glennji/field-outpost-zero/branding/foz-contact-sheet.png

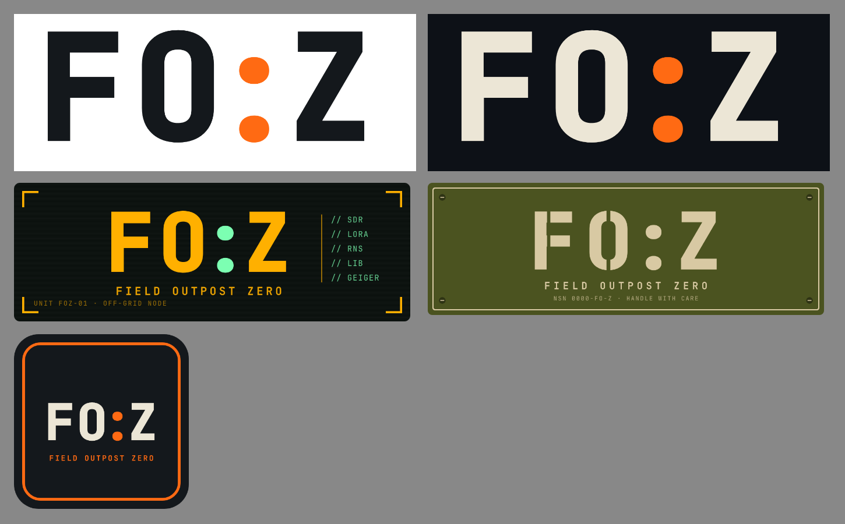
branding/foz-contact-sheet.png
