glennji/field-outpost-zero/branding/foz-wordmark-light.png

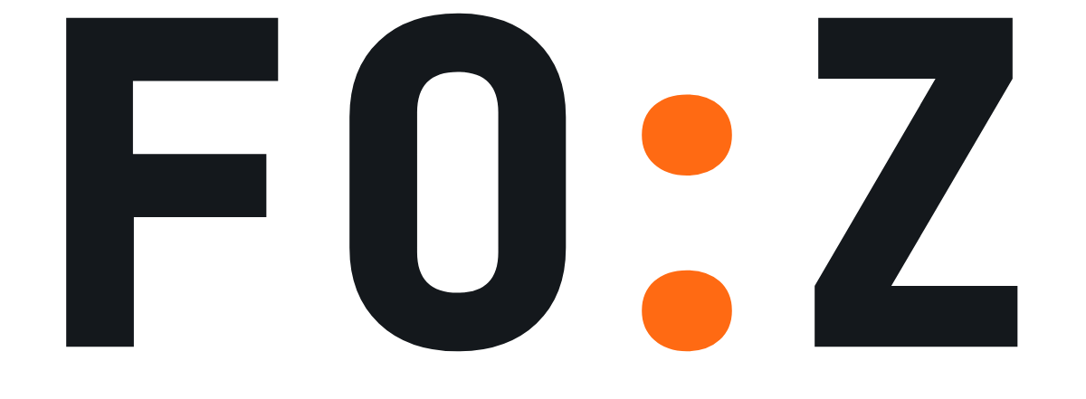
branding/foz-wordmark-light.png
