glennji/field-outpost-zero/preview/base_tile_5x5.png

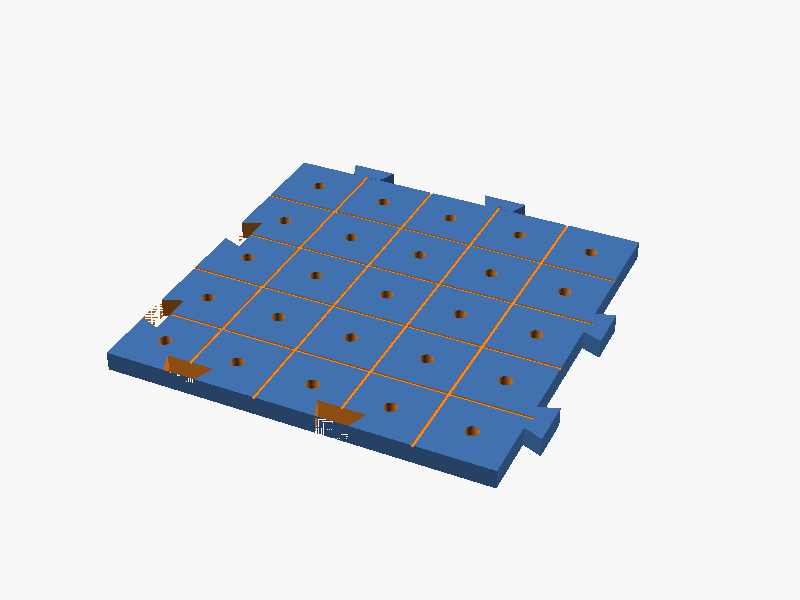
preview/base_tile_5x5.png
