glennji/field-outpost-zero/preview/board_tray_orangepi.png

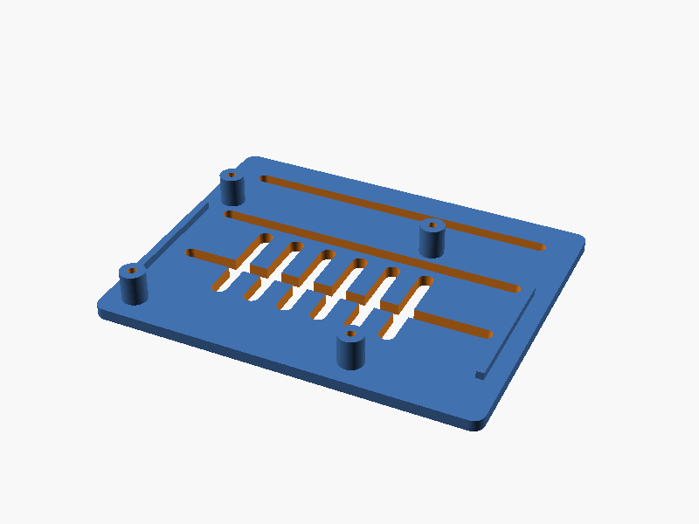
preview/board_tray_orangepi.png
