glennji/field-outpost-zero/preview/contact_sheet.png

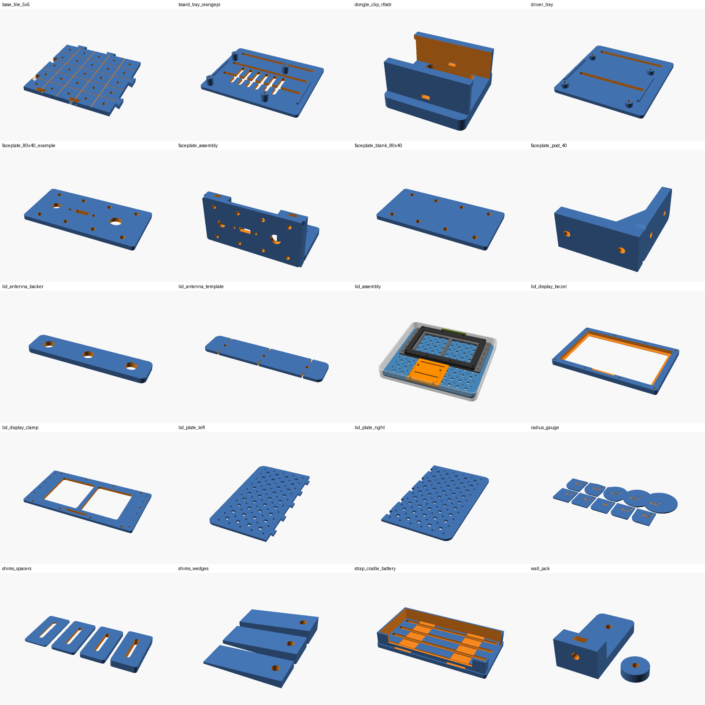
preview/contact_sheet.png
