glennji/field-outpost-zero/preview/dongle_clip_rtlsdr.png

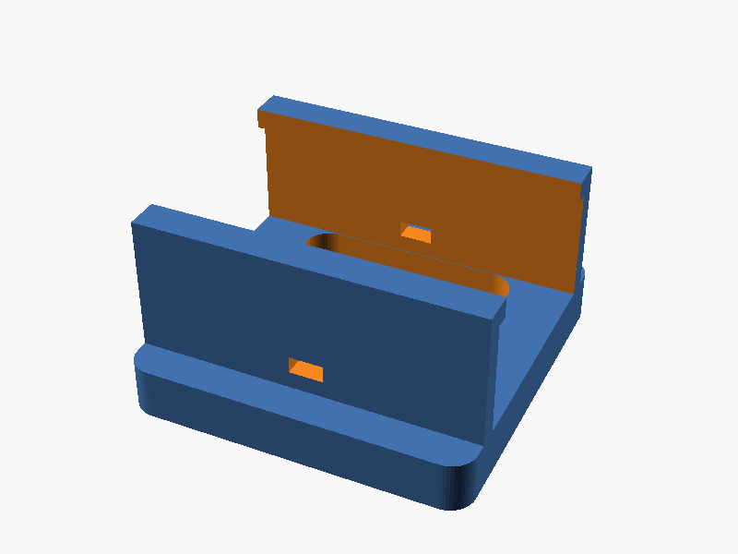
preview/dongle_clip_rtlsdr.png
