glennji/field-outpost-zero/preview/driver_tray.png

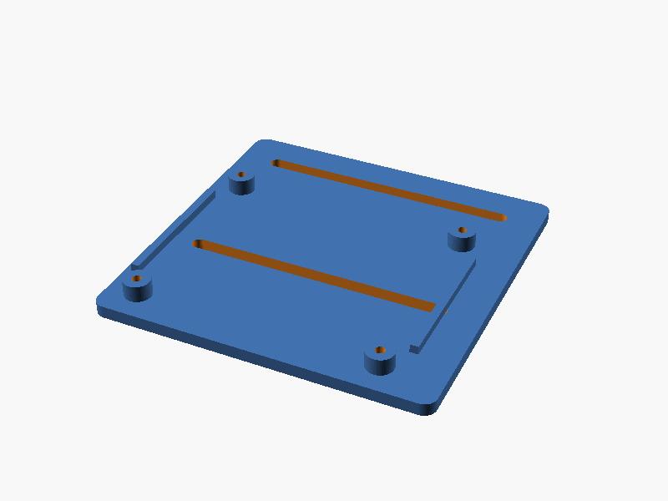
preview/driver_tray.png
