glennji/field-outpost-zero/preview/faceplate_80x40_example.png

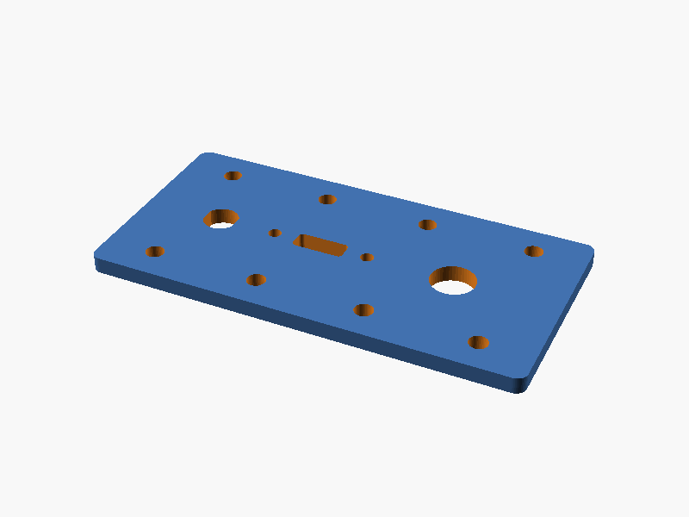
preview/faceplate_80x40_example.png
