glennji/field-outpost-zero/preview/faceplate_post_40.png

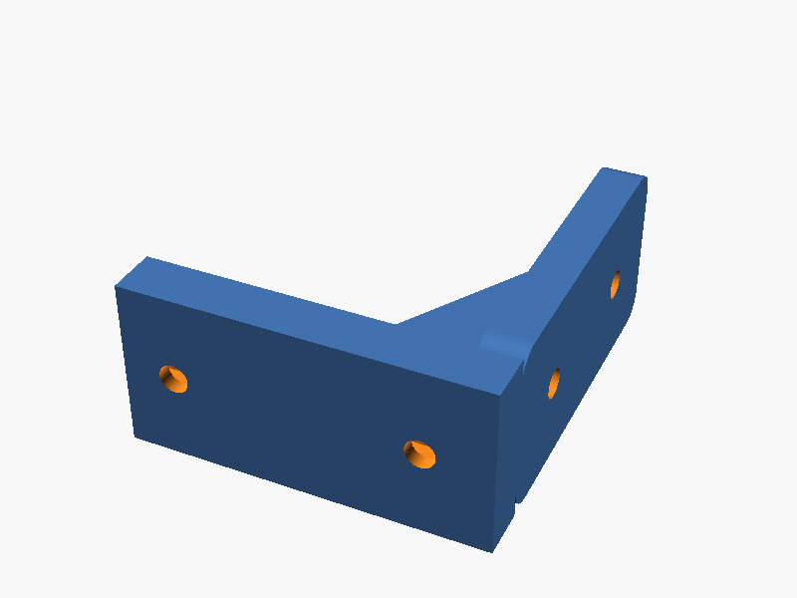
preview/faceplate_post_40.png
