glennji/field-outpost-zero/preview/lid_antenna_backer.png

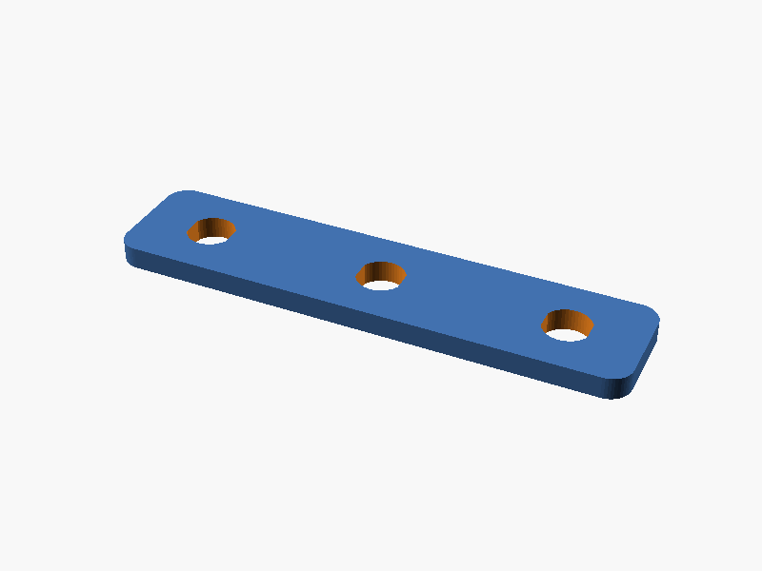
preview/lid_antenna_backer.png
