glennji/field-outpost-zero/preview/lid_display_bezel.png

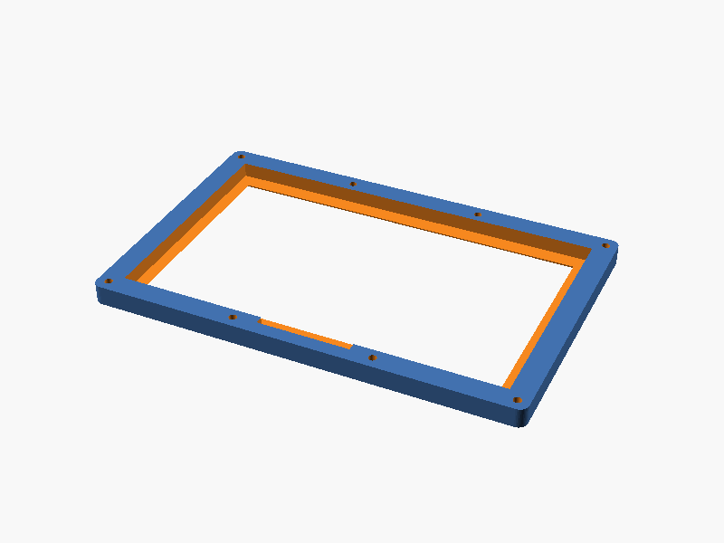
preview/lid_display_bezel.png
