glennji/field-outpost-zero/preview/lid_display_clamp.png

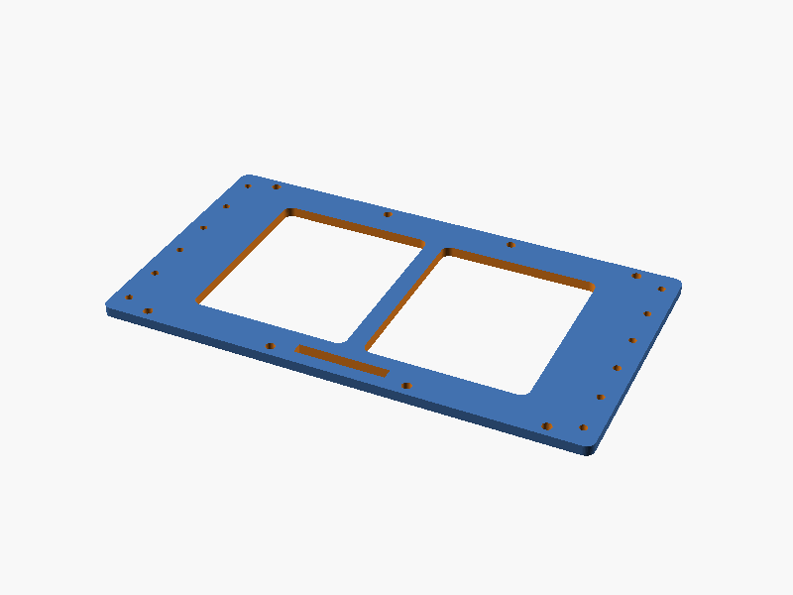
preview/lid_display_clamp.png
