glennji/field-outpost-zero/preview/lid_plate_left.png

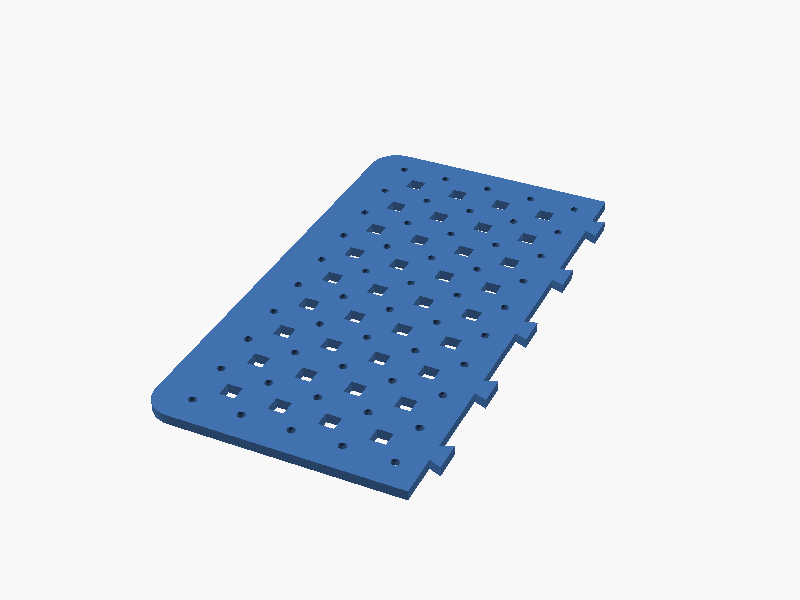
preview/lid_plate_left.png
