glennji/field-outpost-zero/preview/radius_gauge.png

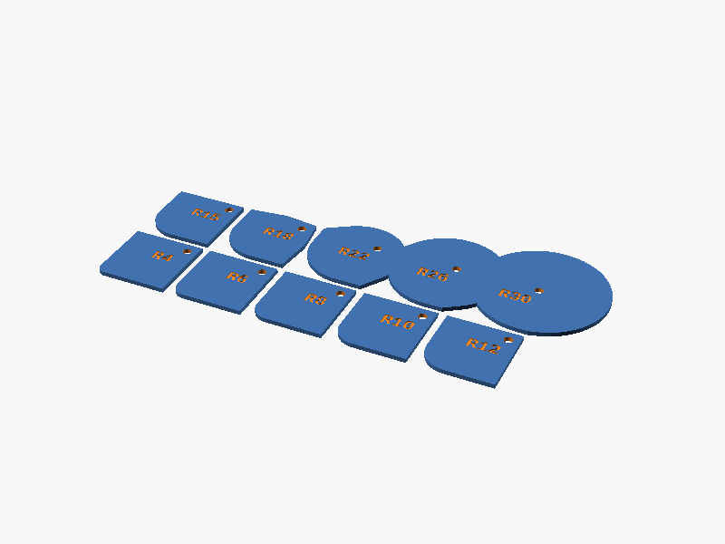
preview/radius_gauge.png
