glennji/field-outpost-zero/preview/shims_wedges.png

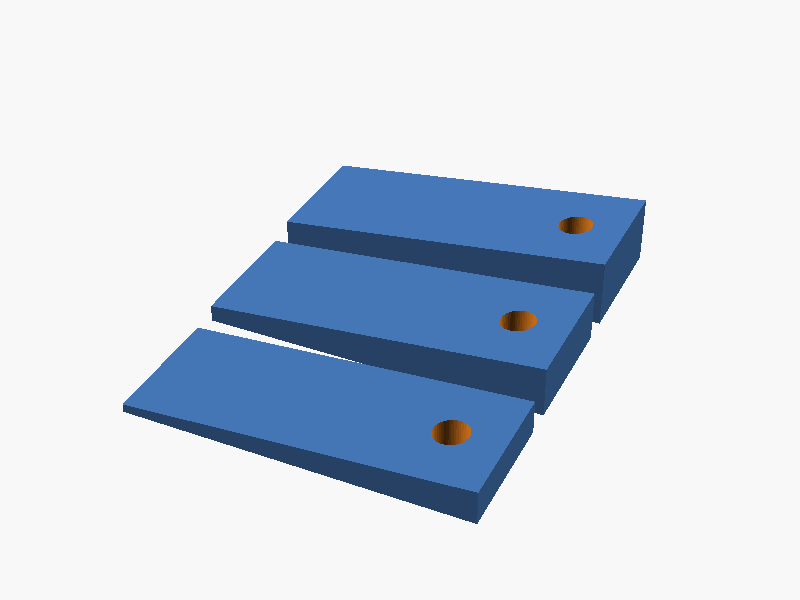
preview/shims_wedges.png
