glennji/field-outpost-zero/preview/wall_jack.png

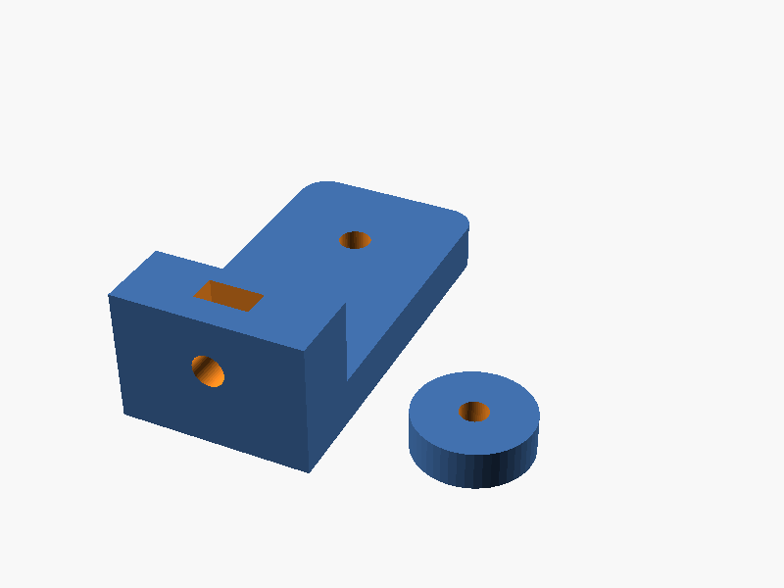
preview/wall_jack.png
