glennji/field-outpost-zero/stl/lid_plate_full.stl

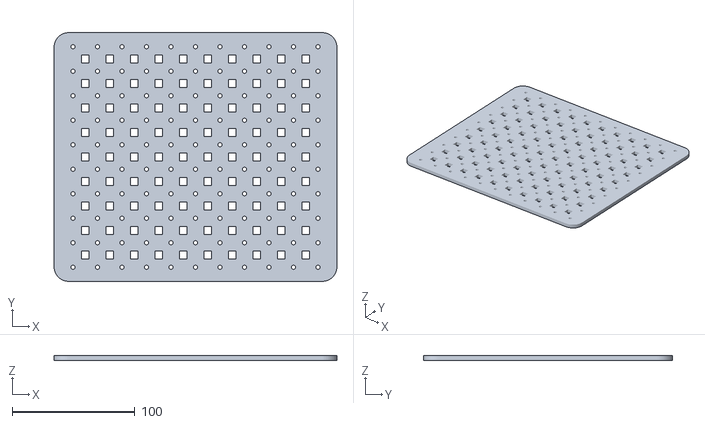
[picture p18: CAD file, 2026-10-24]
stl/lid_plate_full.stl
231.0 x 203.0 x 4.00
