glennji/field-outpost-zero/stl/lid_antenna_template.stl

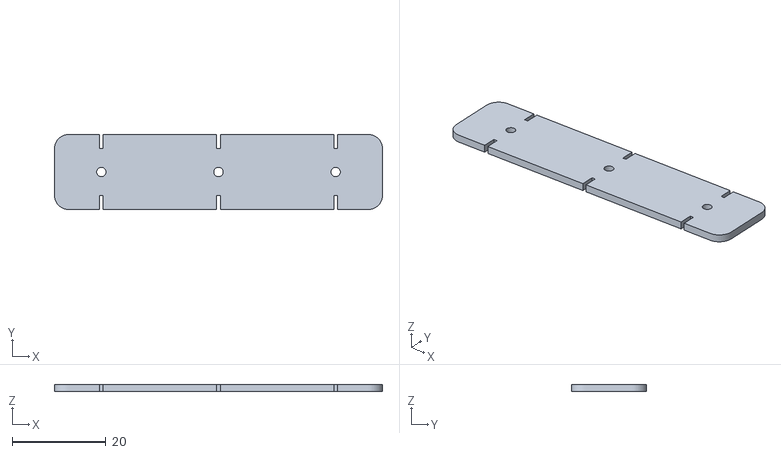
[picture p19: CAD file, 2026-10-24]
stl/lid_antenna_template.stl
70.0 x 16.0 x 1.60
