glennji/field-outpost-zero/stl/lid_plate_left.stl

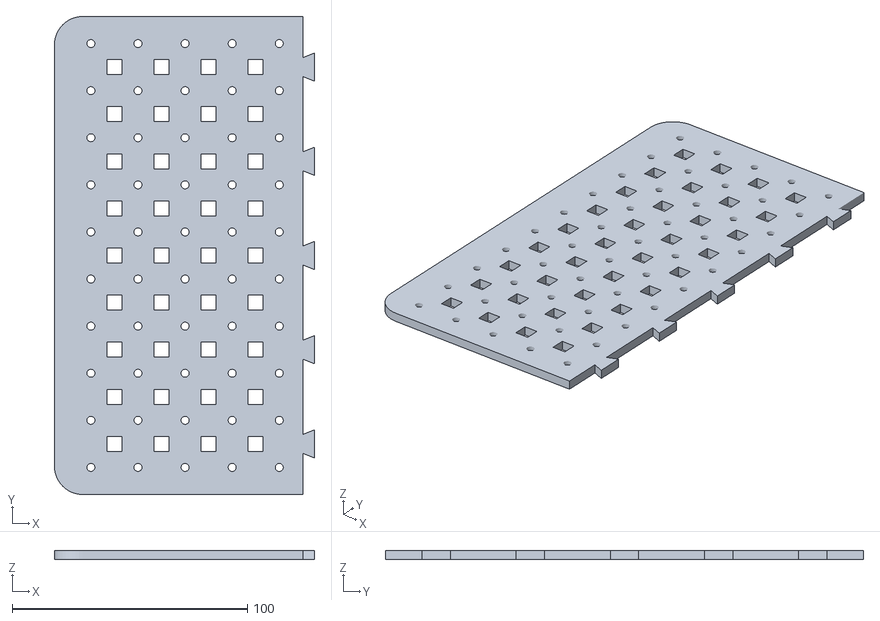
[picture p20: CAD file, 2026-10-24]
stl/lid_plate_left.stl
110.5 x 203.0 x 4.00
