glennji/field-outpost-zero/stl/wall_jack.stl

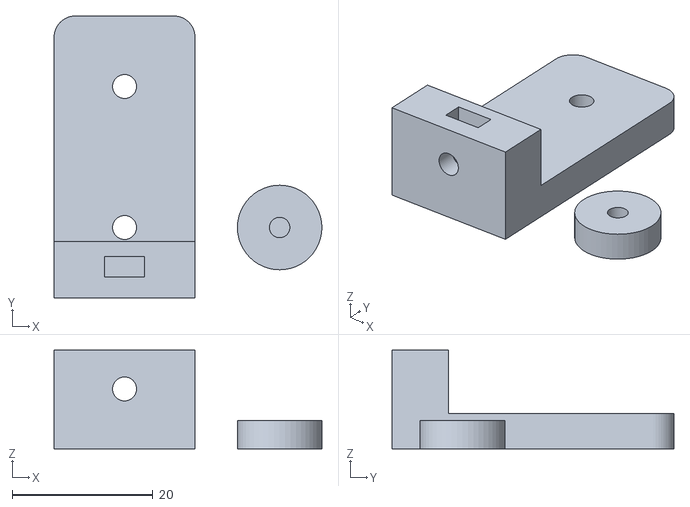
[picture p21: CAD file, 2026-10-24]
stl/wall_jack.stl
38.0 x 40.0 x 14.0
