glennji/field-outpost-zero/stl/lid_antenna_backer.stl

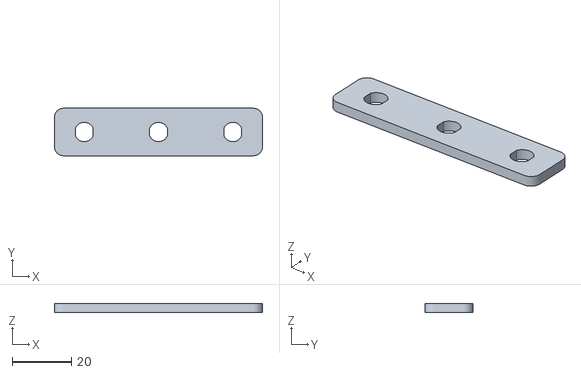
[picture p22: CAD file, 2026-10-24]
stl/lid_antenna_backer.stl
70.0 x 16.0 x 3.00
