glennji/field-outpost-zero/stl/driver_tray.stl

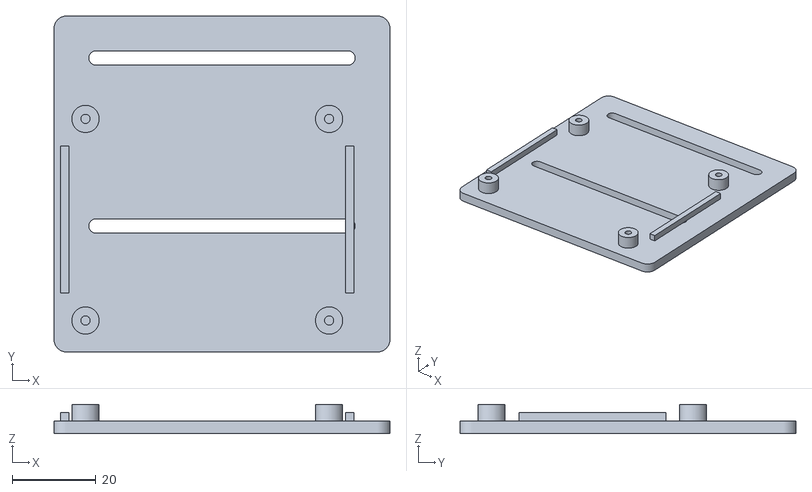
[picture p23: CAD file, 2026-10-24]
stl/driver_tray.stl
80.0 x 80.0 x 7.00
