glennji/field-outpost-zero/stl/dongle_clip_rtlsdr.stl

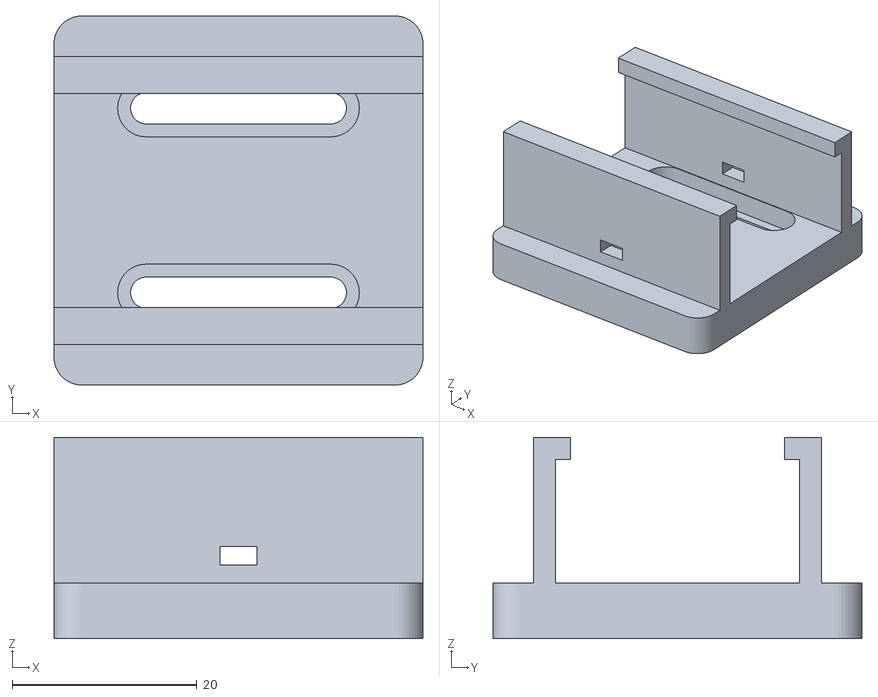
[picture p24: CAD file, 2026-10-24]
stl/dongle_clip_rtlsdr.stl
40.0 x 40.0 x 21.8
