glennji/field-outpost-zero/stl/faceplate_post_40.stl

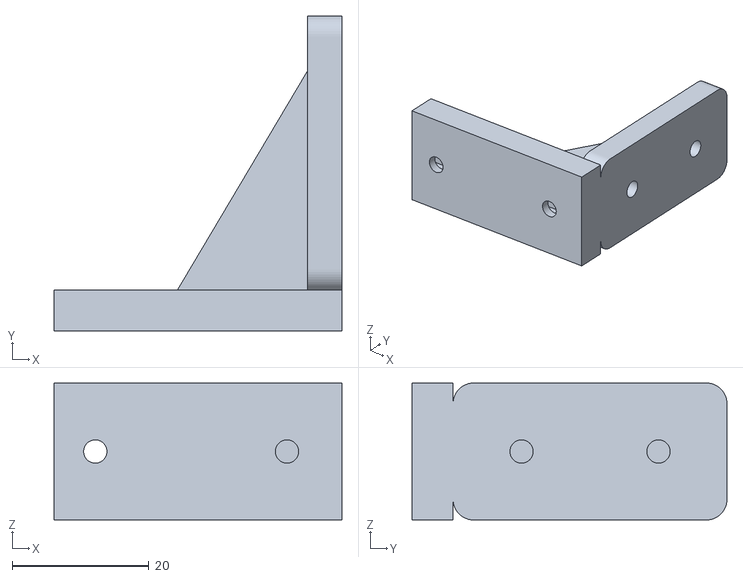
[picture p25: CAD file, 2026-10-24]
stl/faceplate_post_40.stl
42.0 x 46.0 x 20.0
