glennji/field-outpost-zero/stl/lid_plate_right.stl

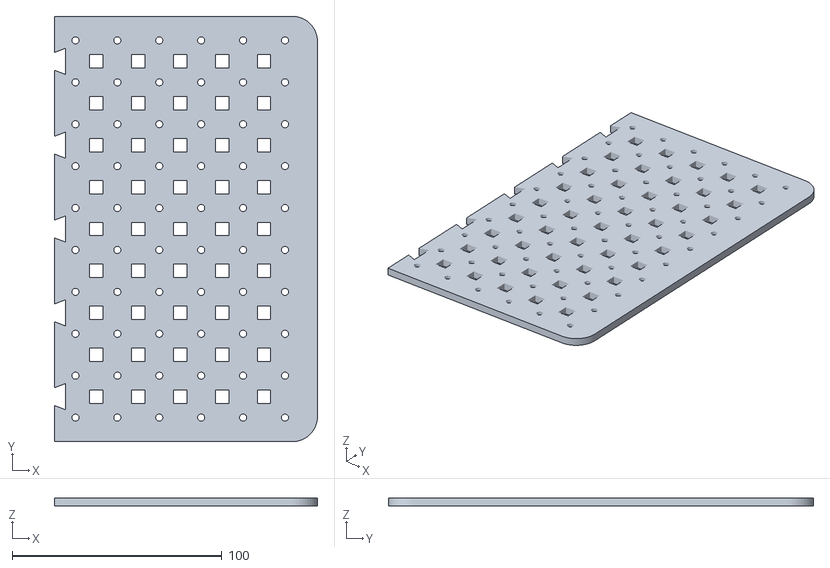
[picture p26: CAD file, 2026-10-24]
stl/lid_plate_right.stl
125.5 x 203.0 x 4.00
