glennji/field-outpost-zero/stl/faceplate_80x40_example.stl

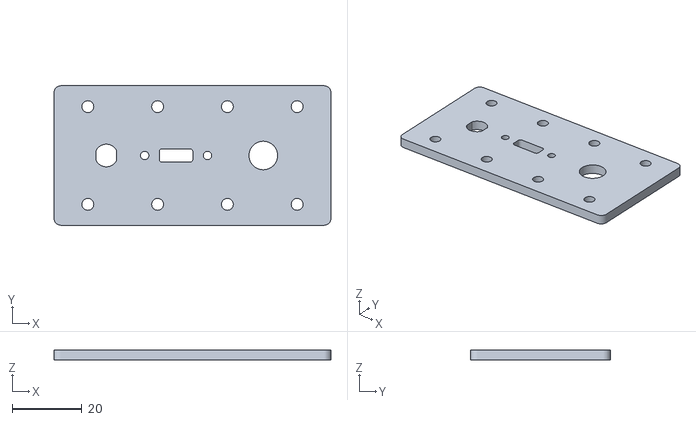
[picture p27: CAD file, 2026-10-24]
stl/faceplate_80x40_example.stl
79.4 x 40.0 x 3.00
