glennji/field-outpost-zero/stl/board_tray_orangepi.stl

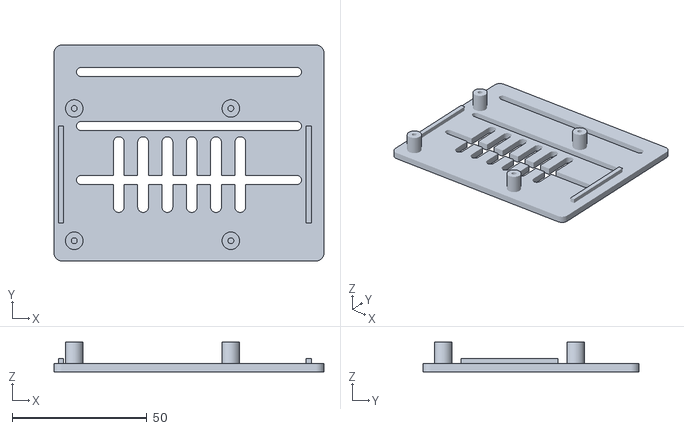
[picture p28: CAD file, 2026-10-24]
stl/board_tray_orangepi.stl
100.0 x 80.0 x 11.0
