glennji/field-outpost-zero/stl/radius_gauge.stl

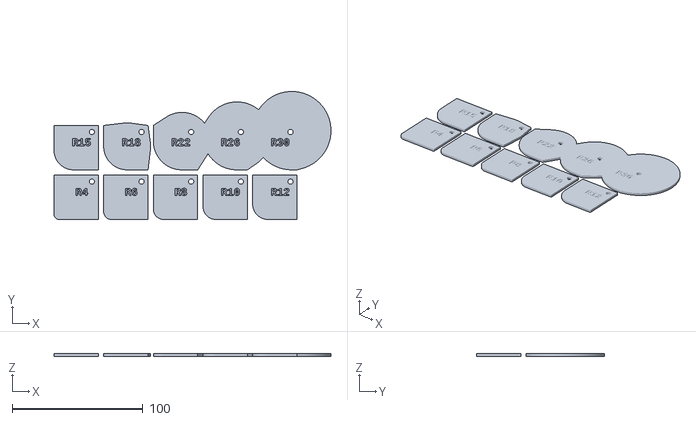
[picture p29: CAD file, 2026-10-24]
stl/radius_gauge.stl
212.0 x 98.0 x 2.00
