glennji/field-outpost-zero/stl/lid_display_bezel.stl

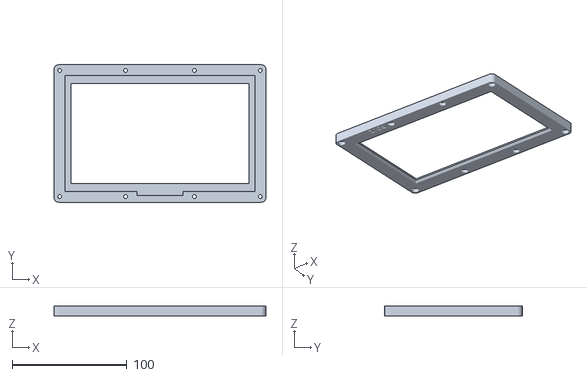
[picture p30: CAD file, 2026-10-24]
stl/lid_display_bezel.stl
185.0 x 120.0 x 8.50
