glennji/field-outpost-zero/stl/shims_wedges.stl

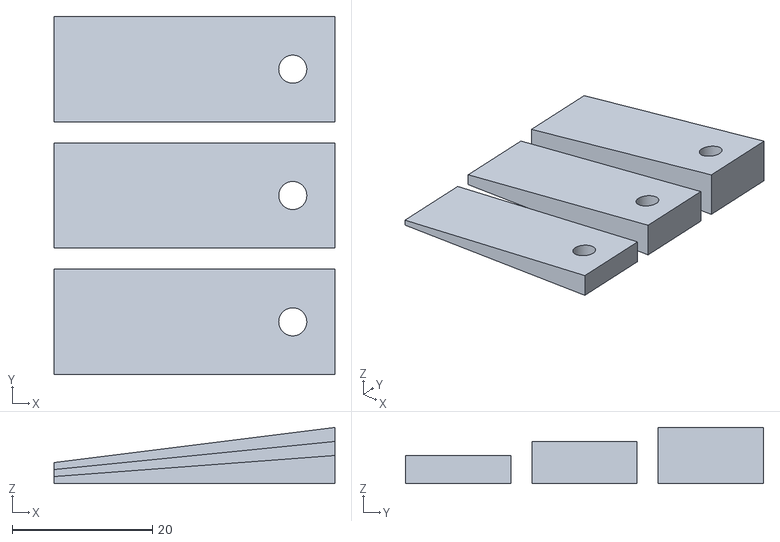
[picture p31: CAD file, 2026-10-24]
stl/shims_wedges.stl
40.0 x 51.0 x 8.00
