glennji/field-outpost-zero/stl/base_tile_5x5.stl

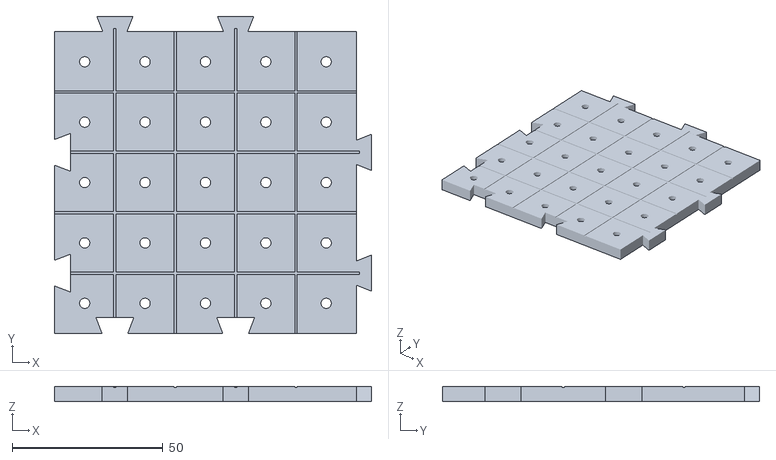
[picture p32: CAD file, 2026-10-24]
stl/base_tile_5x5.stl
105.0 x 105.0 x 5.02
