glennji/field-outpost-zero/stl/lid_display_clamp.stl

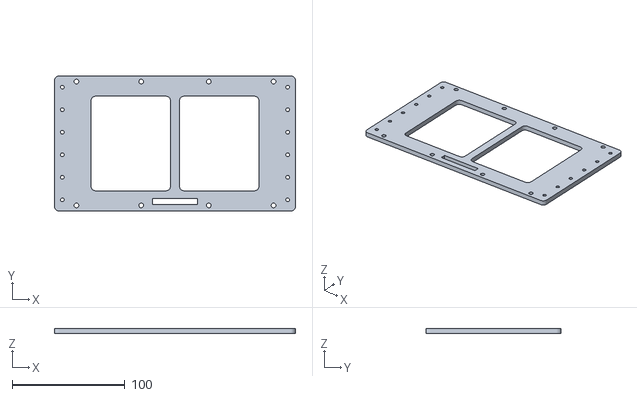
[picture p33: CAD file, 2026-10-24]
stl/lid_display_clamp.stl
214.0 x 120.0 x 4.50
