glennji/field-outpost-zero/stl/shims_spacers.stl

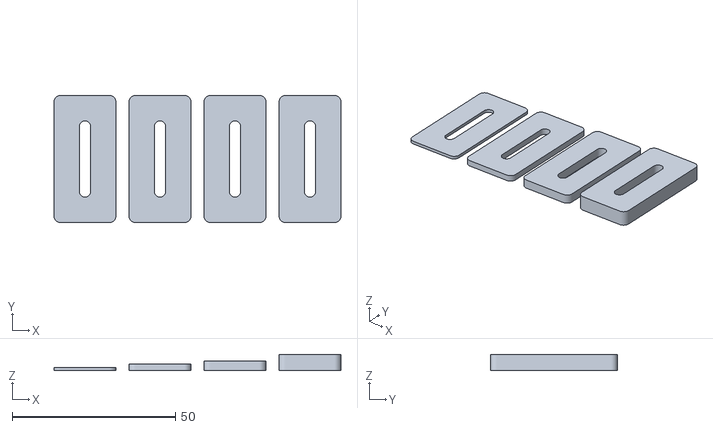
[picture p34: CAD file, 2026-10-24]
stl/shims_spacers.stl
88.0 x 39.0 x 5.00
