glennji/field-outpost-zero/stl/strap_cradle_battery.stl

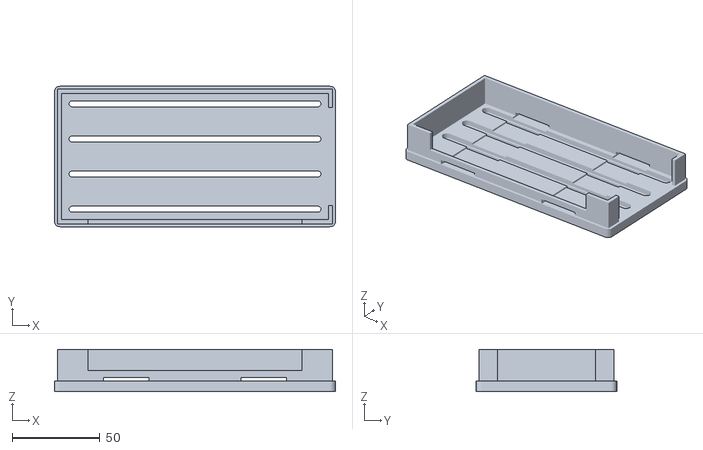
[picture p35: CAD file, 2026-10-24]
stl/strap_cradle_battery.stl
160.0 x 80.0 x 24.0
