glennji/field-outpost-zero/(list of files, cad)

Other CAD files:
stl/faceplate_blank_80x40.stl
