glennji/field-outpost-zero/preview/faceplate_assembly.png

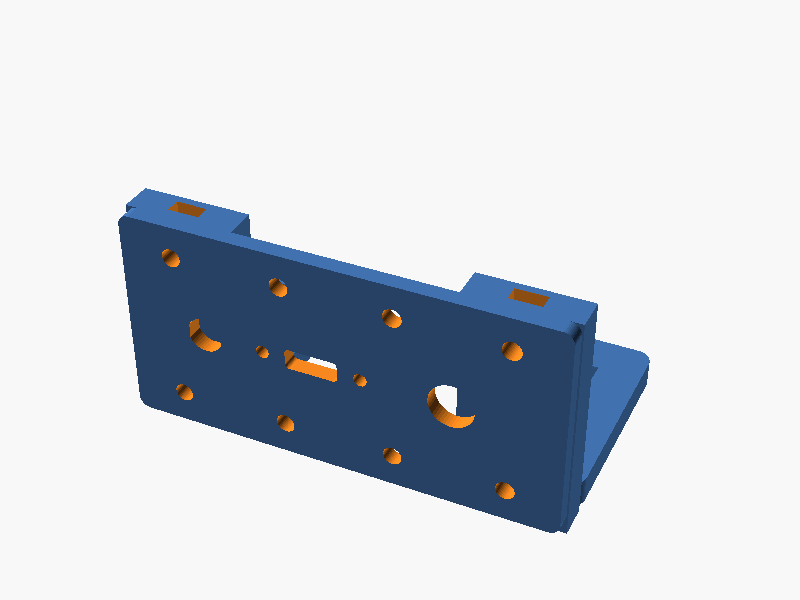
preview/faceplate_assembly.png
