glennji/field-outpost-zero/preview/lid_assembly.png

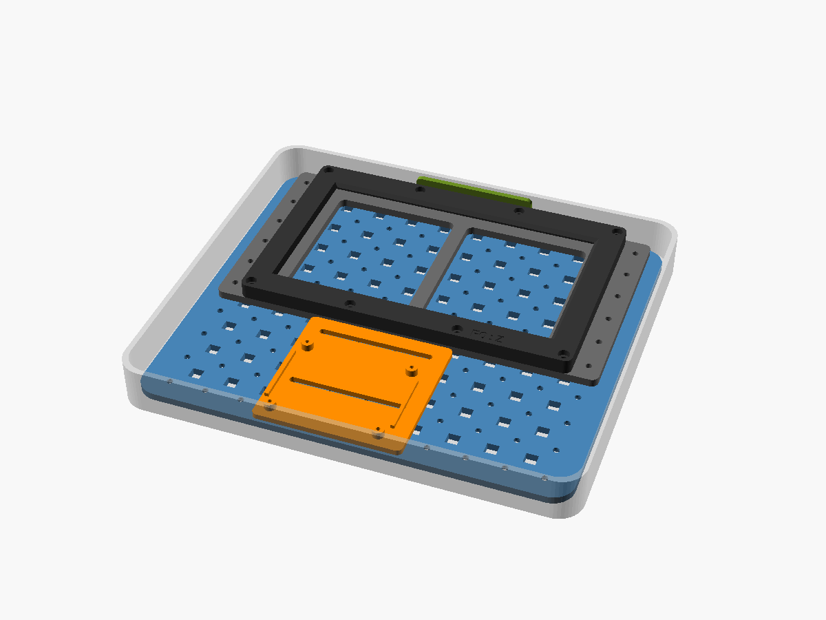
preview/lid_assembly.png
